makermoekoe/Smarthome-dashbutton/Case/Version 2 - round/dash_round_lid3.stl

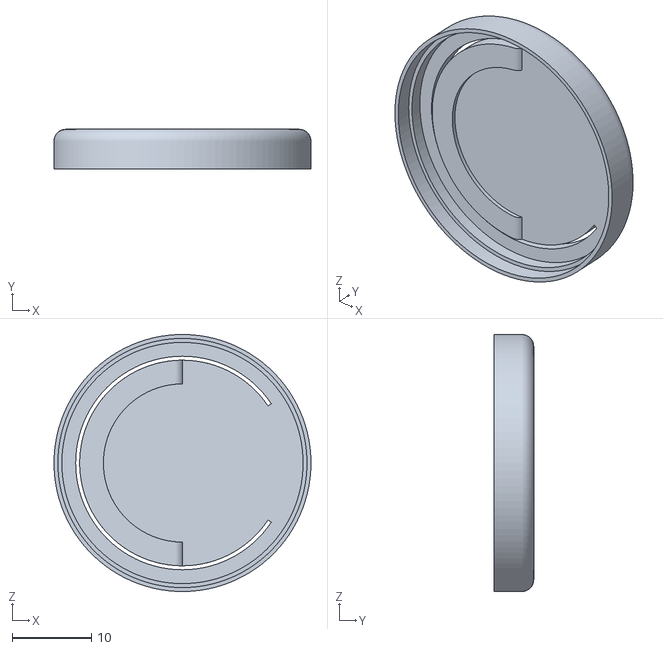
[picture p18: CAD file, 2019-01-24]
Case/Version 2 - round/dash_round_lid3.stl
32.5 x 5.00 x 32.5
