makermoekoe/Smarthome-dashbutton/Case/Version 4 - 2450/dbv4_box.stl

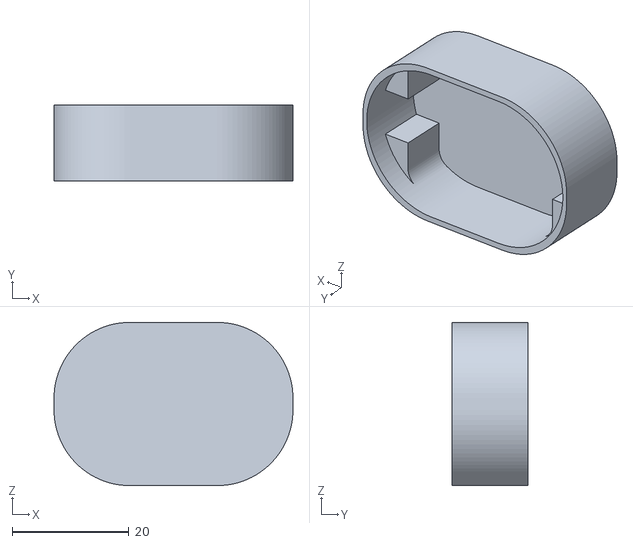
[picture p19: CAD file, 2019-02-22]
Case/Version 4 - 2450/dbv4_box.stl
41.0 x 13.0 x 28.0
