makermoekoe/Smarthome-dashbutton/Case/Version 2 - round/dash_round_box3.stl

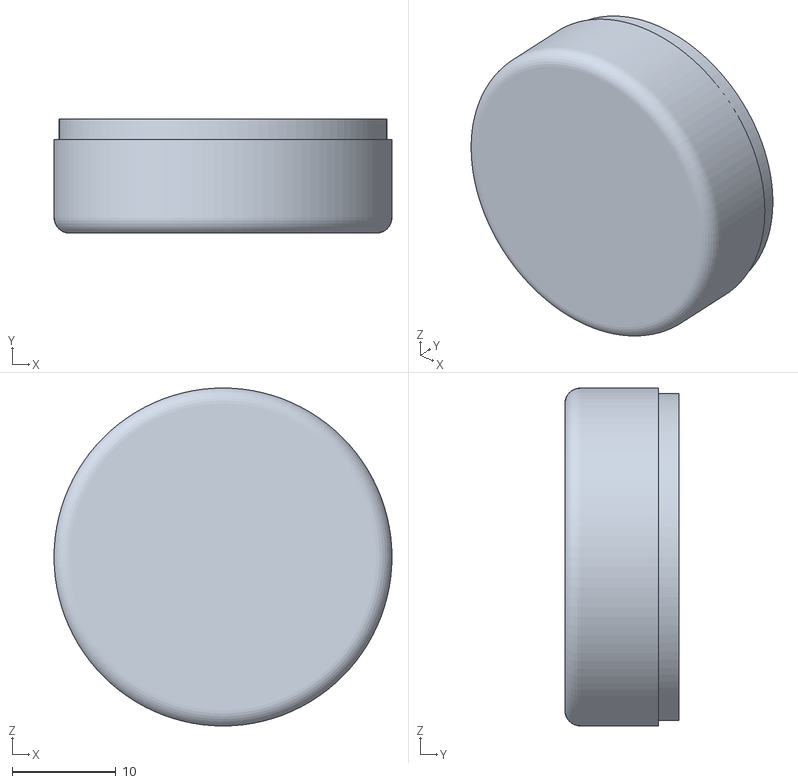
[picture p20: CAD file, 2019-01-24]
Case/Version 2 - round/dash_round_box3.stl
32.5 x 11.0 x 32.5
