makermoekoe/Smarthome-dashbutton/Case/Version 4 - 2450/dbv4_lid.stl

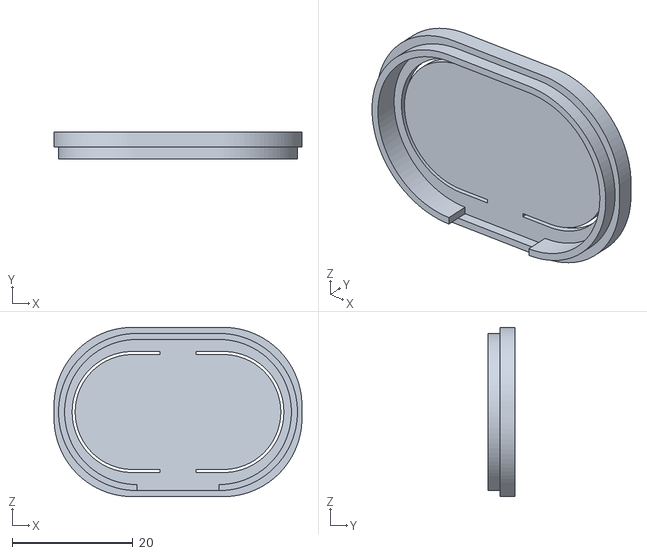
[picture p21: CAD file, 2019-02-22]
Case/Version 4 - 2450/dbv4_lid.stl
41.0 x 4.50 x 28.0
