makermoekoe/Smarthome-dashbutton/(commit log)

2018-12-05 added pcb files
    [esp8285_dashbutton_rect.brd, esp8285_dashbutton_round.brd, esp8285_deepsleep.sch]
2018-12-05 change order
    [esp8285_dashbutton_rect.brd, esp8285_dashbutton_round.brd, esp8285_deepsleep.sch]
2019-01-24 added 3d print case
    [dash_round_box3.stl, dash_round_lid3.stl]
2019-01-24 added 3d case
2019-02-11 added version 4
    [dash_round_box3.stl, dash_round_lid3.stl, dashbutton_2450_v3.brd, dashbutton_2450_v3.sch, dashbutton_2450_v4.brd, dashbutton_2450_v4.sch, dashbutton_rect_v1.brd, dashbutton_rect_v1.sch]
2019-02-19 added Arduino code for v4
2019-02-22 dbv4 case
    [dbv4_box.stl, dbv4_lid.stl]
2019-02-22 added dbv4 case
2019-03-20 added dashbutton v5
    [v5_dashbutton_5wayswitch.brd]
